chregu82/RevoxB780/Emulator/B780.bmp

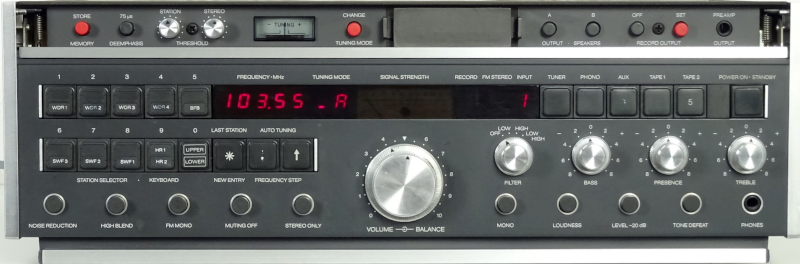
Emulator/B780.bmp
