chregu82/RevoxB780/NewCpuPCB/B780_CPU.kicad_pcb

## KiCad design NewCpuPCB/B780_CPU.kicad_pcb (2024-02-22)

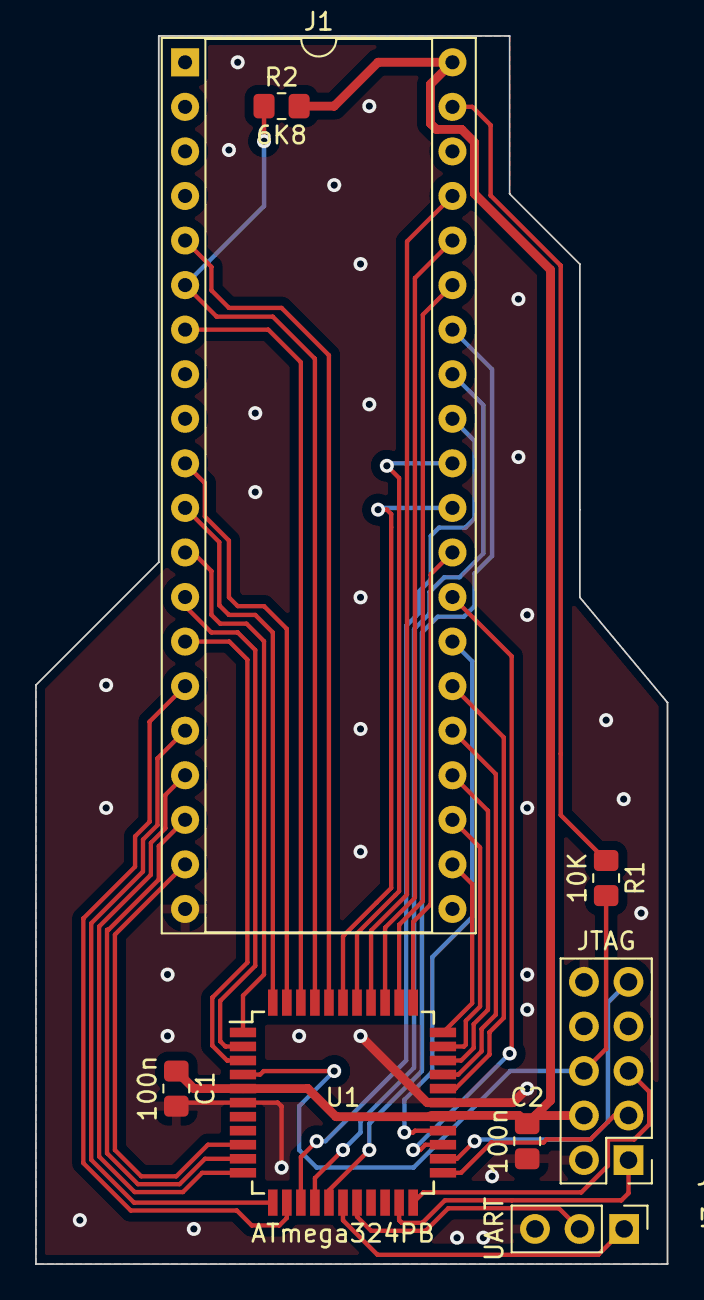
[picture p2: board B780_CPU.kicad_pcb from above]

Board: 2 copper layers, 36.0 x 70.0 mm, 8 parts (0 on the bottom side), 39 nets.

Parts:
C1, C2: 100n; R_0805_2012Metric_Pad1.20x1.40mm_HandSolder
J1: MK3875; DIP-40_W15.24mm_Socket
J2: JTAG; PinHeader_2x05_P2.54mm_Vertical
J3: UART; PinHeader_1x03_P2.54mm_Vertical
R1: 10K; R_0805_2012Metric_Pad1.20x1.40mm_HandSolder
R2: 6K8; R_0805_2012Metric_Pad1.20x1.40mm_HandSolder
U1: ATmega324PB; TQFP-44_10x10mm_P0.8mm

Connections:
GND: C1.2, C2.2, J1.20, J2.2 (GND), J2.10 (GND), J3.3, U1.6 (GND), U1.28 (GND)
unnamed: J1.39, R1.1
unnamed: J3.1, U1.17 (PE2)
unnamed: J3.2, U1.18 (PE3)
P0.2_ST: J1.5, U1.40 (PB0)
P0.3_DON: J1.6, R2.1, U1.41 (PB1)
P0.4_NF1: J1.19, U1.9 (PD0)
P0.5_NF2: J1.18, U1.10 (PD1)
P0.6_NF3: J1.17, U1.11 (PD2)
P0.7_NF4: J1.16, U1.12 (PD3)
P1.0_A: J1.37, U1.37 (PA0)
P1.1_B: J1.36, U1.36 (PA1)
P1.2_C: J1.35, U1.35 (PA2)
P1.3_S: J1.34, U1.16 (PD7)
P1.5_NF6: J1.23, U1.32 (PA5)
P1.6_NF7: J1.24, U1.31 (PA6)
P1.7_NF5: J1.22, U1.33 (PA4)
P1.7_NF8: J1.25, U1.30 (PA7)
P4.2_DLEN5: J1.10, U1.43 (PB3)
P4.3_DLEN4: J1.11, U1.44 (PB4)
P4.4_DLEN3: J1.12, U1.1 (PB5)
P4.5_DLEN2: J1.13, U1.2 (PB6)
P4.6_DLEN1: J1.14, U1.3 (PB7)
P4.7_DATA: J1.15, U1.13 (PD4)
P5.0_PH: J1.33, U1.15 (PD6)
P5.1_PONLR: J1.32, U1.14 (PD5)
P5.2_Z: J1.31, U1.38 (PE5)
P5.3_Mul6: J1.30, U1.39 (PE6)
P5.4_Mul7: J1.29, U1.34 (PA3)
P5.5_Mul8: J1.28, U1.25 (PC6)
P5.6_Mul9: J1.27, U1.26 (PC7)
P5.7_Mul10: J1.26, U1.29 (PE4/AREF)
RESET: J2.6 (~SRST), R1.2, U1.4 (~RESET)
STROBE: J1.7, U1.42 (PB2)
TCK: J2.1 (TCK), U1.21 (PC2)
TDI: J2.9 (TDI), U1.24 (PC5)
TDO: J2.3 (TDO), U1.23 (PC4)
TMS: J2.5 (TMS), U1.22 (PC3)
VCC: C1.1, C2.1, J1.40, J2.4 (VREF), R2.2, U1.5 (VCC), U1.27 (AVCC)
