chregu82/RevoxB780/FirmwareDumper/PCB/MostekDumper.kicad_pcb

## KiCad design FirmwareDumper/PCB/MostekDumper.kicad_pcb (2024-01-23)

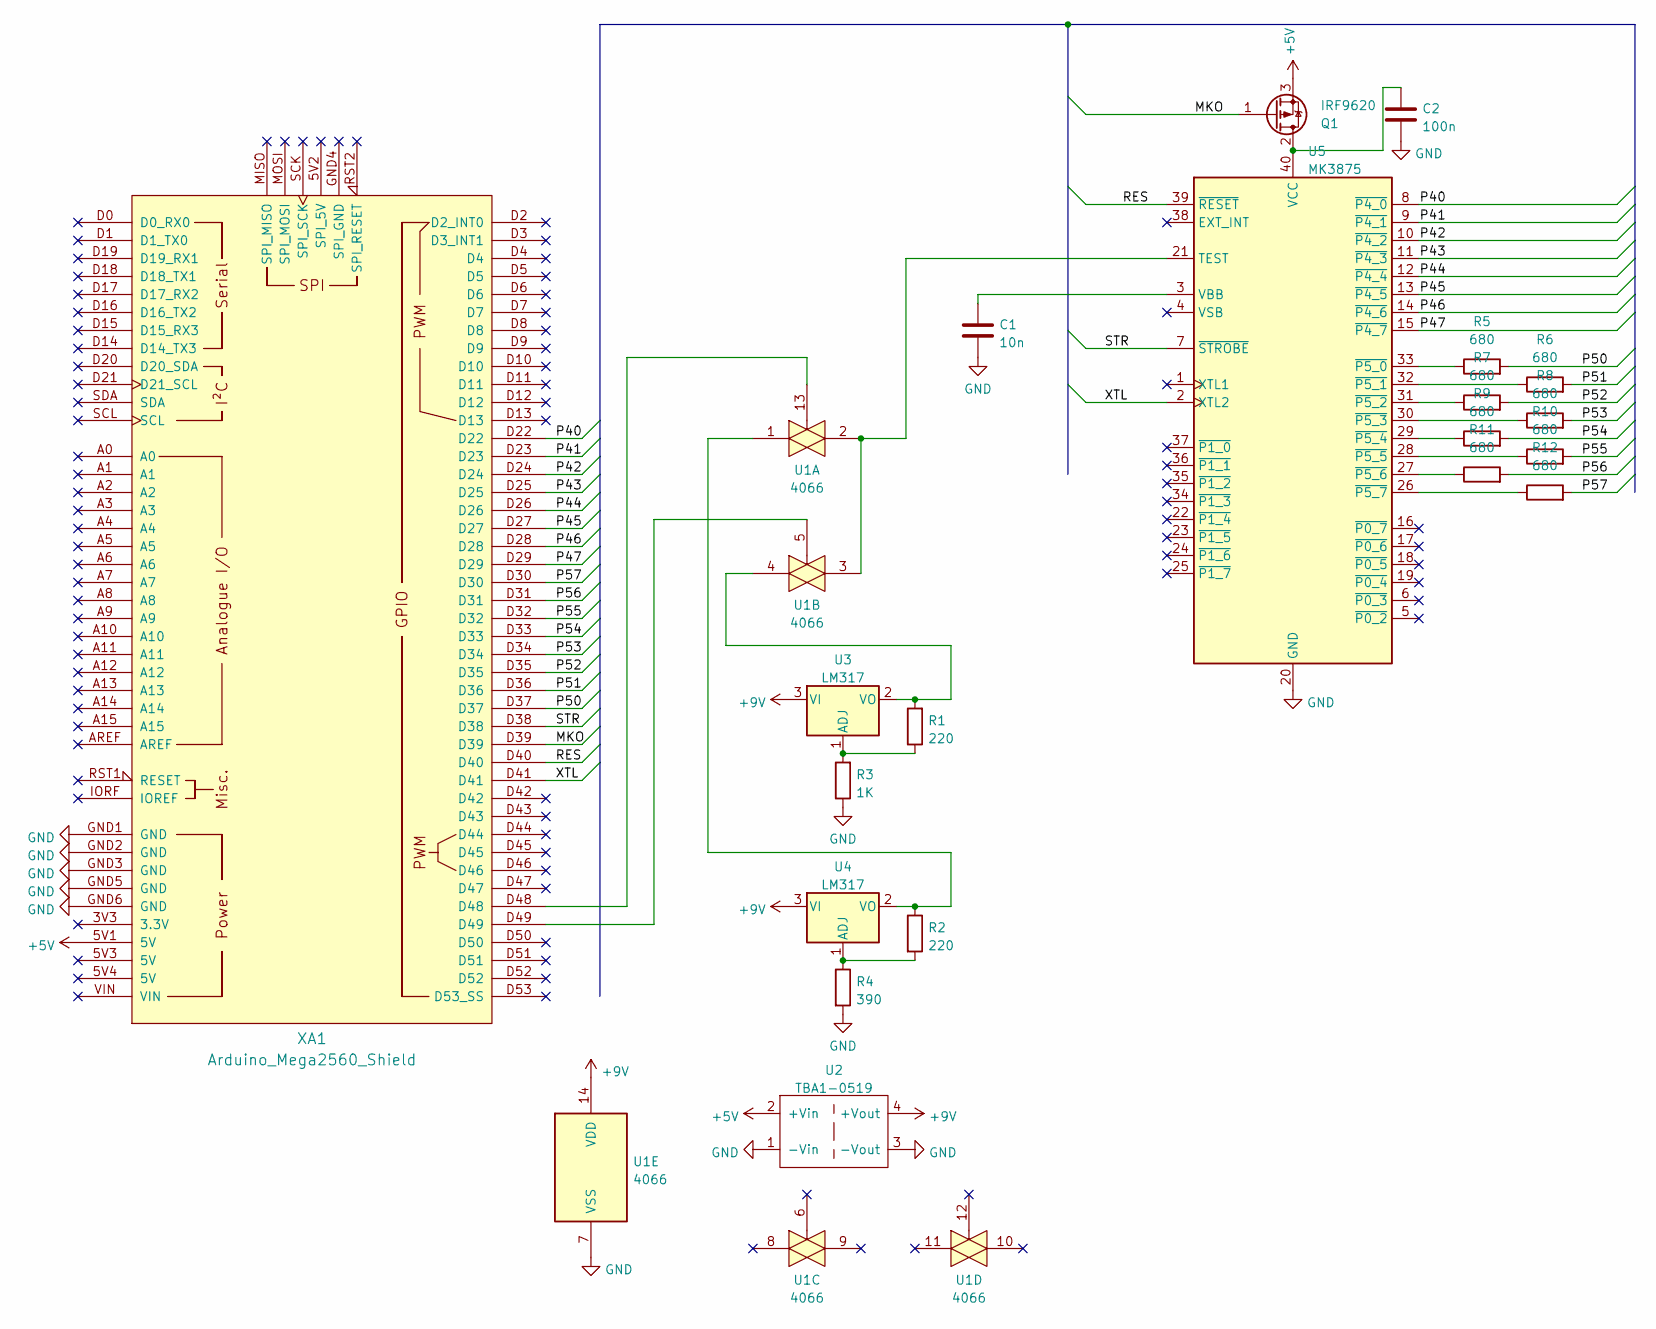
[picture p3: schematic MostekDumper.kicad_sch]

Parts:
C1: 10n; C_Disc_D3.0mm_W1.6mm_P2.50mm
C2: 100n; C_Disc_D4.3mm_W1.9mm_P5.00mm
Q1: IRF9620; TO-220-3_Vertical
R1, R2: 220; R_Axial_DIN0207_L6.3mm_D2.5mm_P10.16mm_Horizontal
R3: 1K; R_Axial_DIN0207_L6.3mm_D2.5mm_P10.16mm_Horizontal
R4: 390; R_Axial_DIN0207_L6.3mm_D2.5mm_P10.16mm_Horizontal
R5, R6, R7, R8, R9, R10, R11, R12: 680; R_Axial_DIN0207_L6.3mm_D2.5mm_P10.16mm_Horizontal
U1: 4066; DIP-14_W7.62mm_Socket
U2: TBA1-0519; TEA1-0505
U3, U4: LM317; TO-92_Inline
U5: MK3875; DIP-40_W15.24mm_Socket
XA1: Arduino_Mega2560_Shield

Connections:
+5V: Q1.3 (S), U2.2 (+Vin), XA1.5V1 (5V)
+9V: U1.14 (VDD), U2.4 (+Vout), U3.3 (VI), U4.3 (VI)
/MKO: Q1.1 (G), XA1.D39
/P40: U5.8 (~P4_0), XA1.D22
/P41: U5.9 (~P4_1), XA1.D23
/P42: U5.10 (~P4_2), XA1.D24
/P43: U5.11 (~P4_3), XA1.D25
/P44: U5.12 (~P4_4), XA1.D26
/P45: U5.13 (~P4_5), XA1.D27
/P46: U5.14 (~P4_6), XA1.D28
/P47: U5.15 (~P4_7), XA1.D29
/P50: R5.2, XA1.D37
/P51: R6.2, XA1.D36
/P52: R7.2, XA1.D35
/P53: R8.2, XA1.D34
/P54: R9.2, XA1.D33
/P55: R10.2, XA1.D32
/P56: R11.2, XA1.D31
/P57: R12.2, XA1.D30
/RES: U5.39 (~RESET), XA1.D40
/STR: U5.7 (~STROBE), XA1.D38
/XTL: U5.2 (XTL2), XA1.D41
GND: C1.2, C2.2, R3.1, R4.2, U1.7 (VSS), U2.1 (-Vin), U2.3 (-Vout), U5.20 (GND), XA1.GND1 (GND), XA1.GND2 (GND), XA1.GND3 (GND), XA1.GND5 (GND), XA1.GND6 (GND)
unnamed: C1.1, U5.3 (VBB)
unnamed: R1.1, R3.2, U3.1 (ADJ)
unnamed: R1.2, U1.4, U3.2 (VO)
unnamed: R2.1, U1.1, U4.2 (VO)
unnamed: R2.2, R4.1, U4.1 (ADJ)
unnamed: R5.1, U5.33 (~P5_0)
unnamed: R6.1, U5.32 (~P5_1)
unnamed: R7.1, U5.31 (~P5_2)
unnamed: R8.1, U5.30 (~P5_3)
unnamed: R9.1, U5.29 (~P5_4)
unnamed: R10.1, U5.28 (~P5_5)
unnamed: R11.1, U5.27 (~P5_6)
unnamed: R12.1, U5.26 (~P5_7)
unnamed: U1.2, U1.3, U5.21 (TEST)
unnamed: U1.5, XA1.D49
unnamed: U1.13, XA1.D48
unnamed: C2.1, Q1.2 (D), U5.40 (VCC)

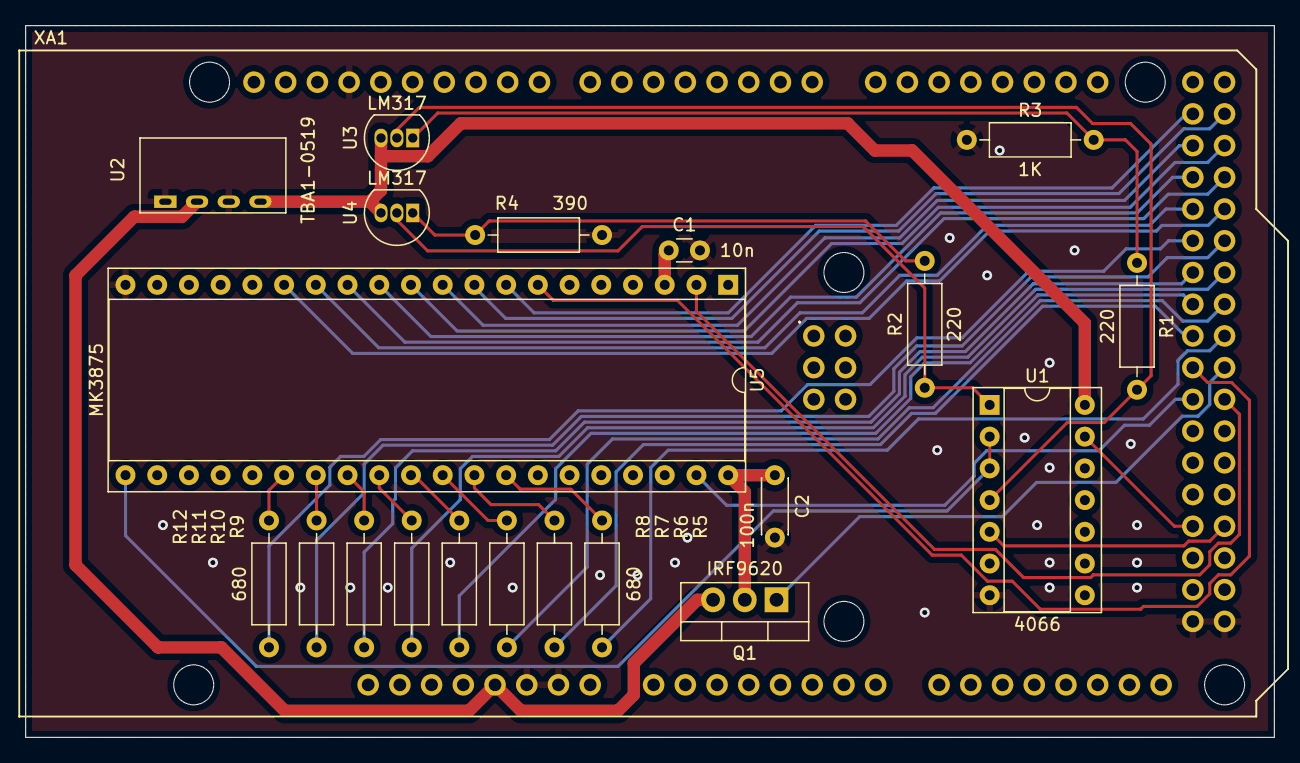
[picture p4: board MostekDumper.kicad_pcb from above]

Board: 2 copper layers, 100.0 x 57.0 mm, 21 parts (0 on the bottom side), 40 nets.
