chregu82/RevoxB780/(commit log)

2024-01-23 Firmware dumper software, PCB, decompiler and datasheets
    [MostekDumper-B_Cu.gbr, MostekDumper-B_Mask.gbr, MostekDumper-B_Paste.gbr, MostekDumper-B_Silkscreen.gbr, MostekDumper-Edge_Cuts.gbr, MostekDumper-F_Cu.gbr, MostekDumper-F_Mask.gbr, MostekDumper-F_Paste.gbr]
2024-02-22 New CPU board as direct replacement
    [B780_CPU-B_Cu.gbr, B780_CPU-B_Mask.gbr, B780_CPU-B_Paste.gbr, B780_CPU-B_Silkscreen.gbr, B780_CPU-Edge_Cuts.gbr, B780_CPU-F_Cu.gbr, B780_CPU-F_Mask.gbr, B780_CPU-F_Paste.gbr]
2024-02-25 Atmega project
    [B780_CPU.kicad_sch]
2024-03-14 Bugfix for play selection
    [ports.c]
2024-03-19 Redesign of right display
    [b780_main.c, ports.c, ports.h]
2024-03-23 AutoTuning
    AutoTuning kind of working, built a TimeOnDelay Function, small bugfixes
    [b780_main.c, ports.c, ports.h, timer.c, timer.h, tuner.h]
